MinhBao19/mech5720-2026-programmable-aperture/Outputs/psf_mtf/lcd_nayar.png

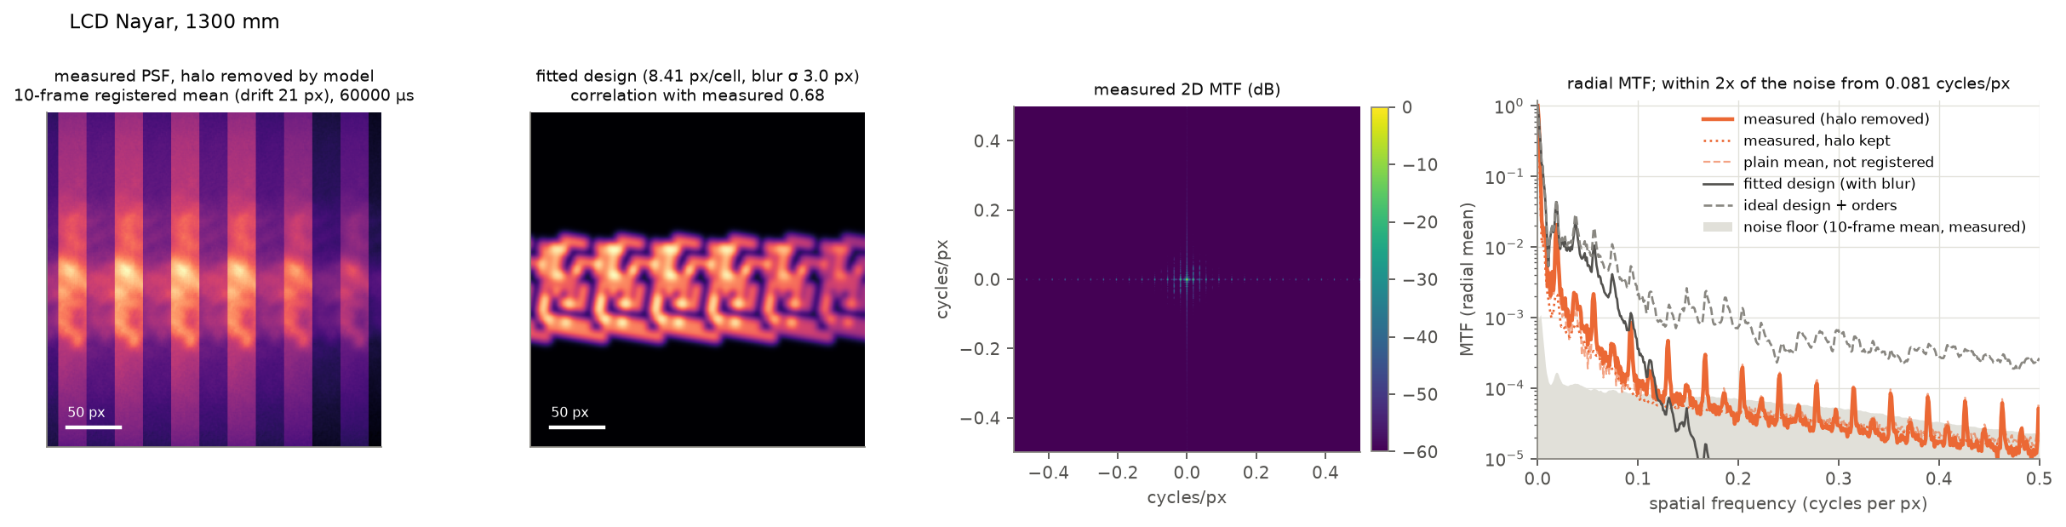
Outputs/psf_mtf/lcd_nayar.png
