MinhBao19/mech5720-2026-programmable-aperture/Outputs/psf_mtf/mtf_all.png

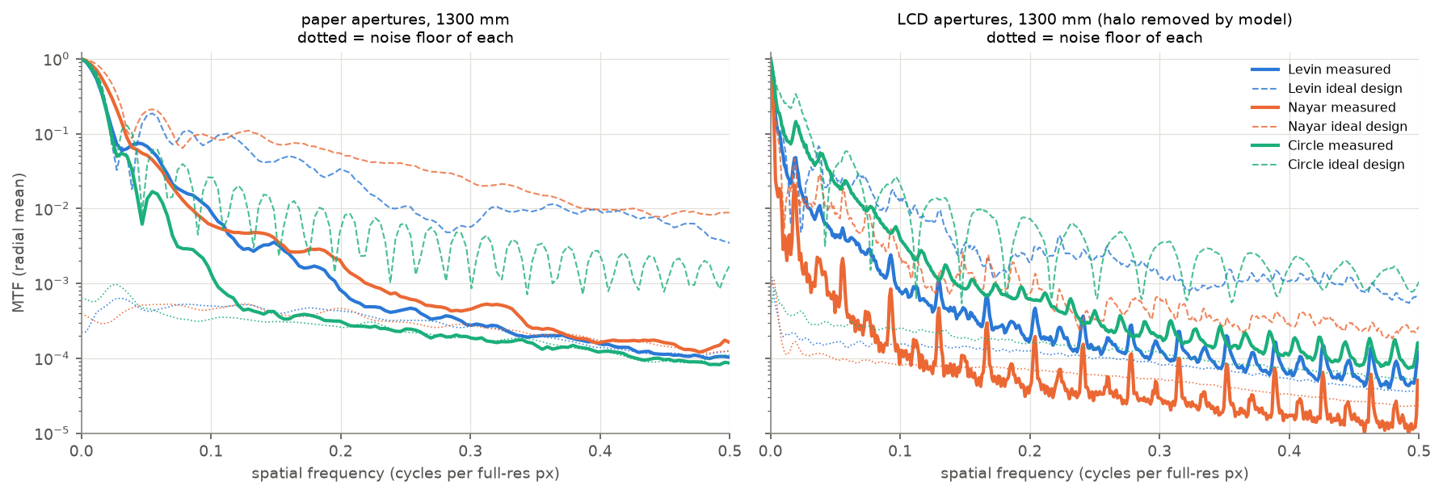
Outputs/psf_mtf/mtf_all.png
