MinhBao19/mech5720-2026-programmable-aperture/Outputs/psf_mtf/paper_levin.png

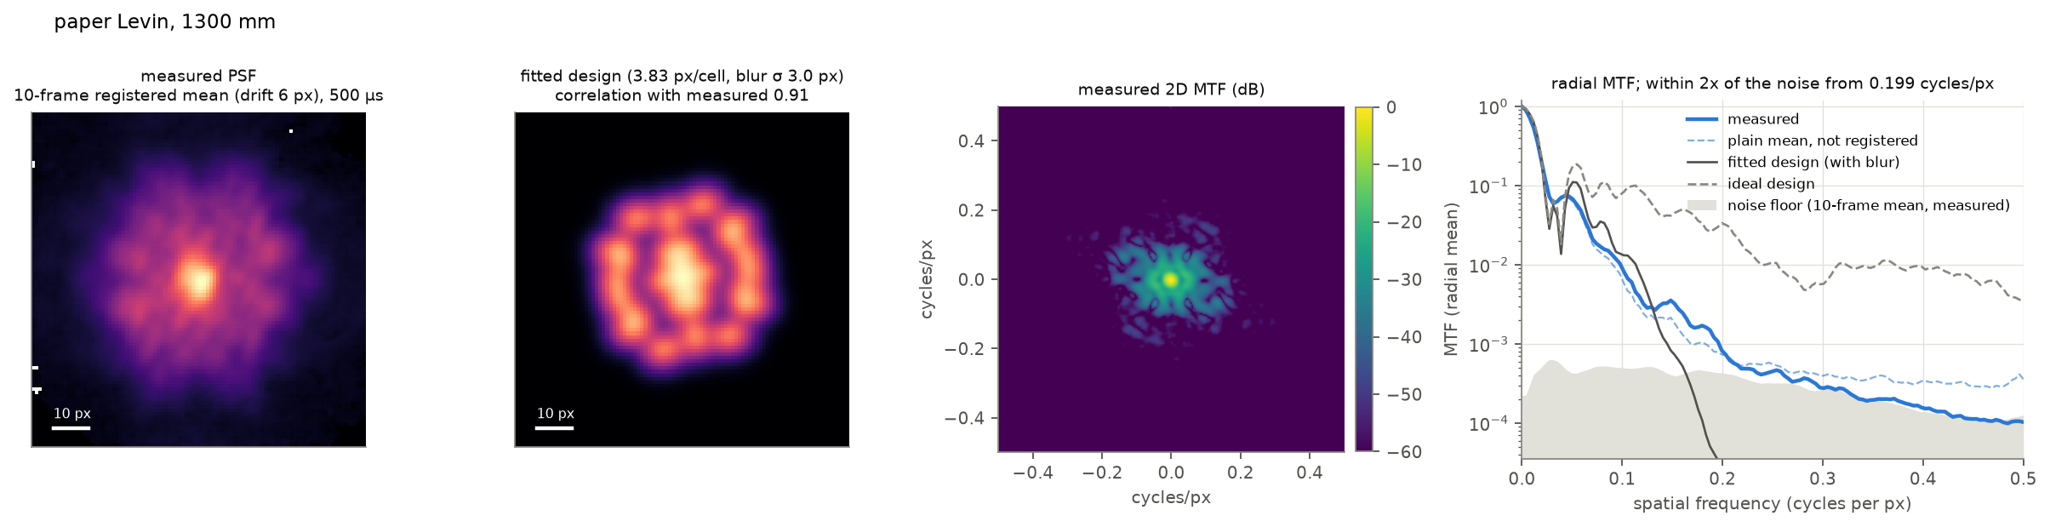
Outputs/psf_mtf/paper_levin.png
