MinhBao19/mech5720-2026-programmable-aperture/Hardware/DXFs/64_and_48_masks.DXF

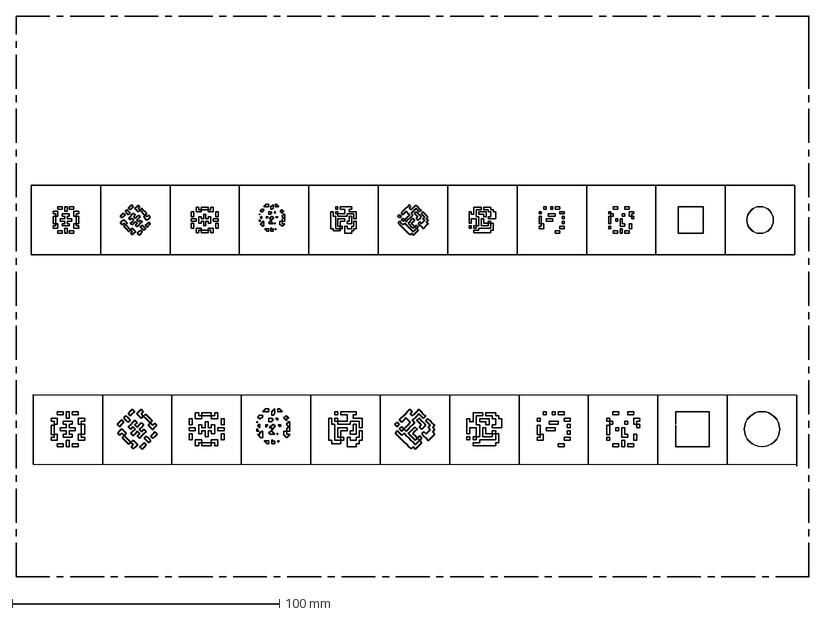
[picture p20: CAD file, 2026-11-04]
Hardware/DXFs/64_and_48_masks.DXF
297.0 x 210.0 mm
