MinhBao19/mech5720-2026-programmable-aperture/Hardware/DXFs/16_and_12_masks.DXF

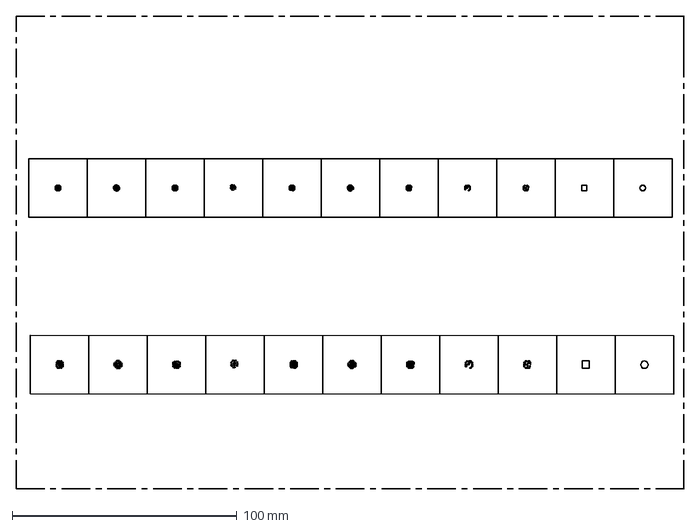
[picture p21: CAD file, 2026-11-04]
Hardware/DXFs/16_and_12_masks.DXF
297.0 x 210.0 mm
