MinhBao19/mech5720-2026-programmable-aperture/(list of files, cad)

Other CAD files:
Hardware/CAD/LCD_Lens_Holder.f3d
Hardware/CAD/Lens Tube.f3d
Hardware/CAD/Mask_Lens_holder.f3d
