MinhBao19/mech5720-2026-programmable-aperture/(commit log)

2026-11-04 Added folders and DXFs
    [16_and_12_masks.DXF, 32_and_24_masks.DXF, 64_and_48_masks.DXF]
2026-11-08 Update holder renders and add Fusion CAD files
    [LCD_Lens_Holder.f3d, Lens Tube.f3d, Mask_Lens_holder.f3d]
2026-11-08 Rename Physical Structure folder to Hardware
    [16_and_12_masks.DXF, 32_and_24_masks.DXF, 64_and_48_masks.DXF, LCD_Lens_Holder.f3d, Lens Tube.f3d, Mask_Lens_holder.f3d]
2026-11-08 Add Outputs folder with PSF/MTF analysis, deconvolution results and report figures
    [candidates.csv, summary.csv]
2026-11-08 Keep only report outputs in Outputs folder
    [candidates.csv]
